LisandroMT/arduino_torreta/images/Gemini_Generated_Image_thl9xkthl9xkthl9.png

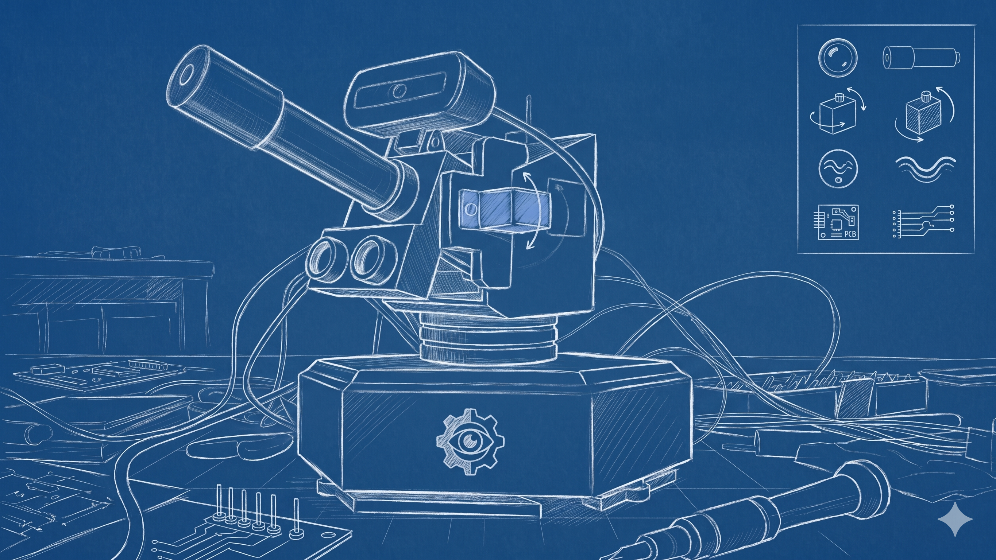
images/Gemini_Generated_Image_thl9xkthl9xkthl9.png
