LisandroMT/arduino_torreta/docs/img/cam1.jpeg

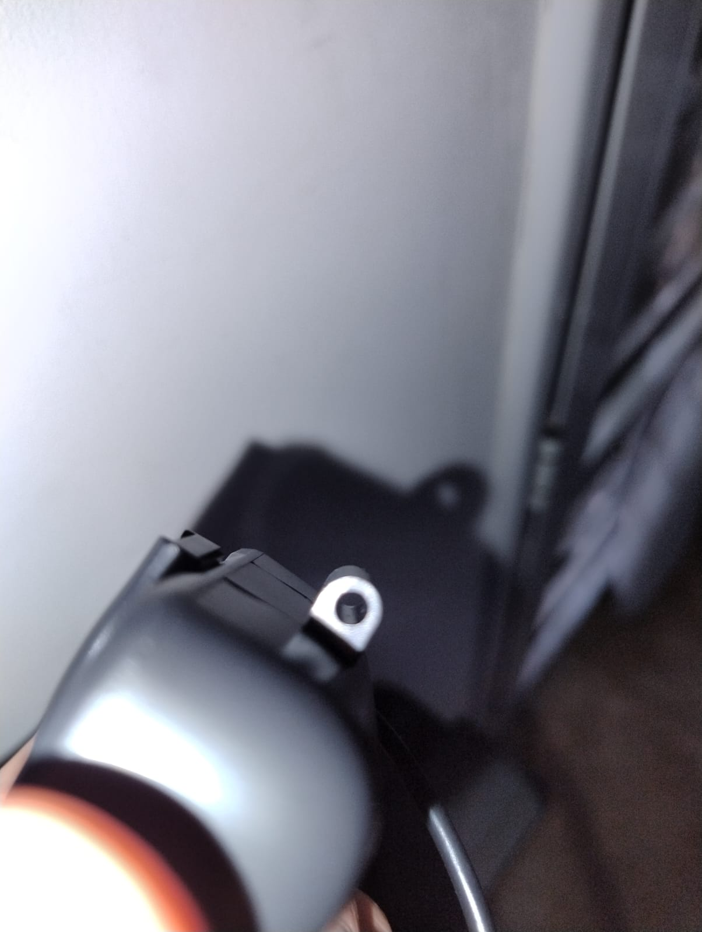
docs/img/cam1.jpeg
