LisandroMT/arduino_torreta/docs/img/cam2.jpeg

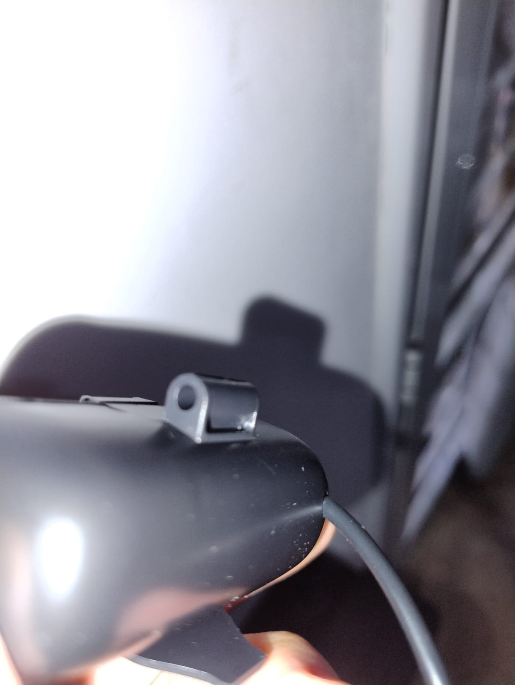
docs/img/cam2.jpeg
