LisandroMT/arduino_torreta/docs/img/cam3.jpeg

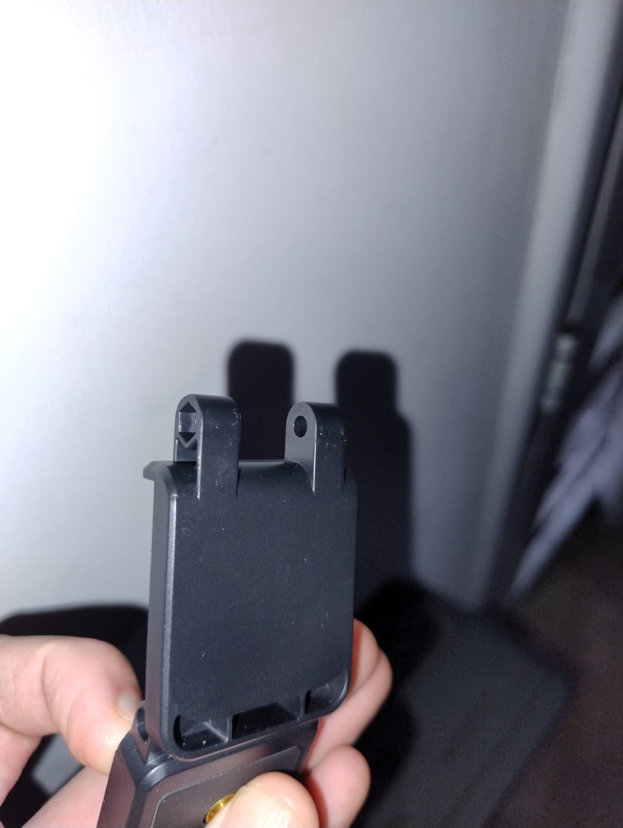
docs/img/cam3.jpeg
