LisandroMT/arduino_torreta/docs/img/cam5.jpeg

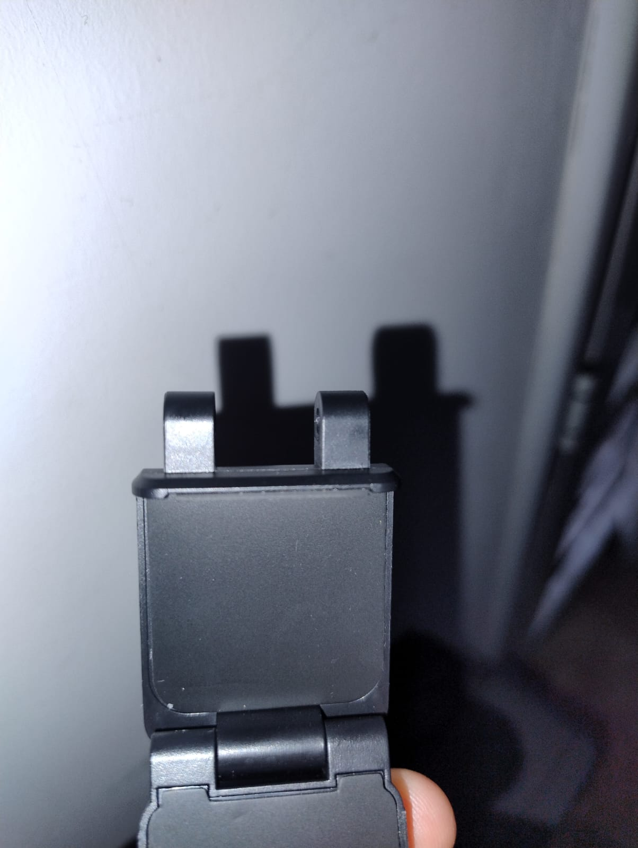
docs/img/cam5.jpeg
