LisandroMT/arduino_torreta/docs/img/cam6.jpeg

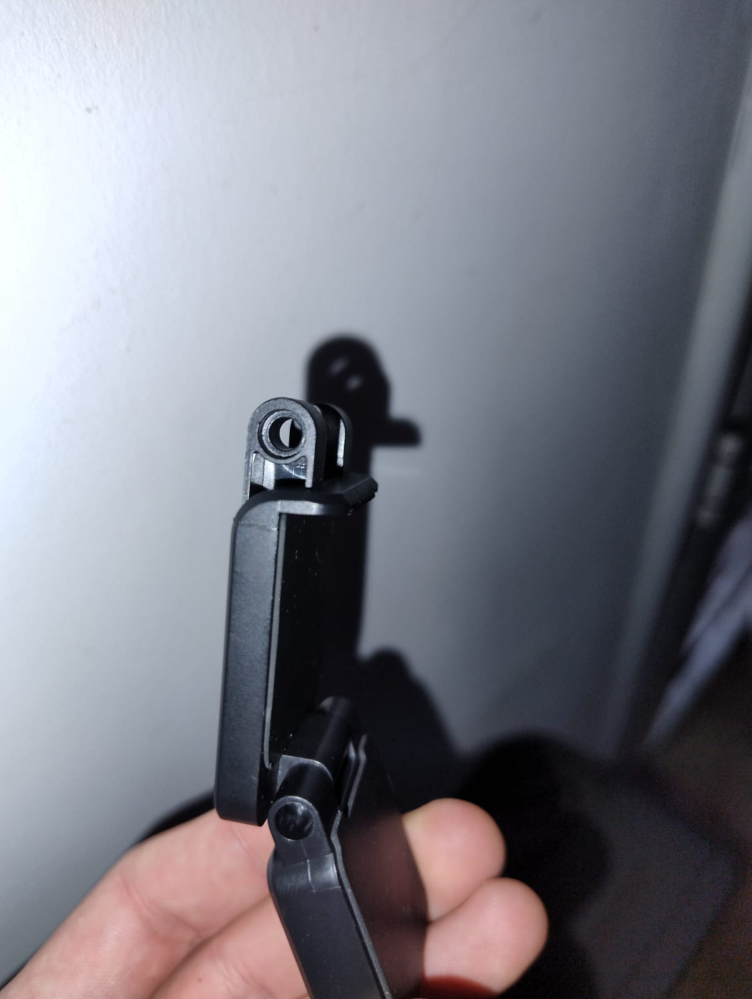
docs/img/cam6.jpeg
