LisandroMT/arduino_torreta/docs/img/esquema_conexiones.png

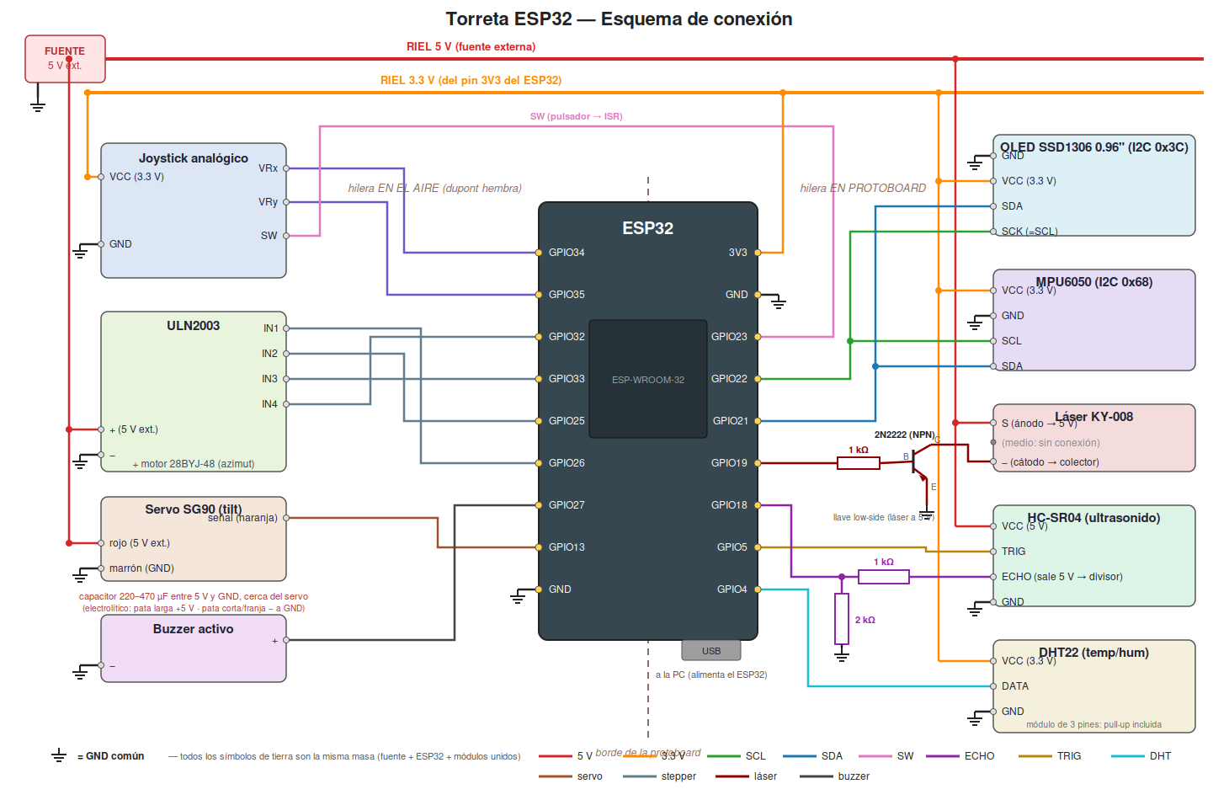
docs/img/esquema_conexiones.png
