LisandroMT/arduino_torreta/images/Gemini_Generated_Image_1i4kce1i4kce1i4k.png

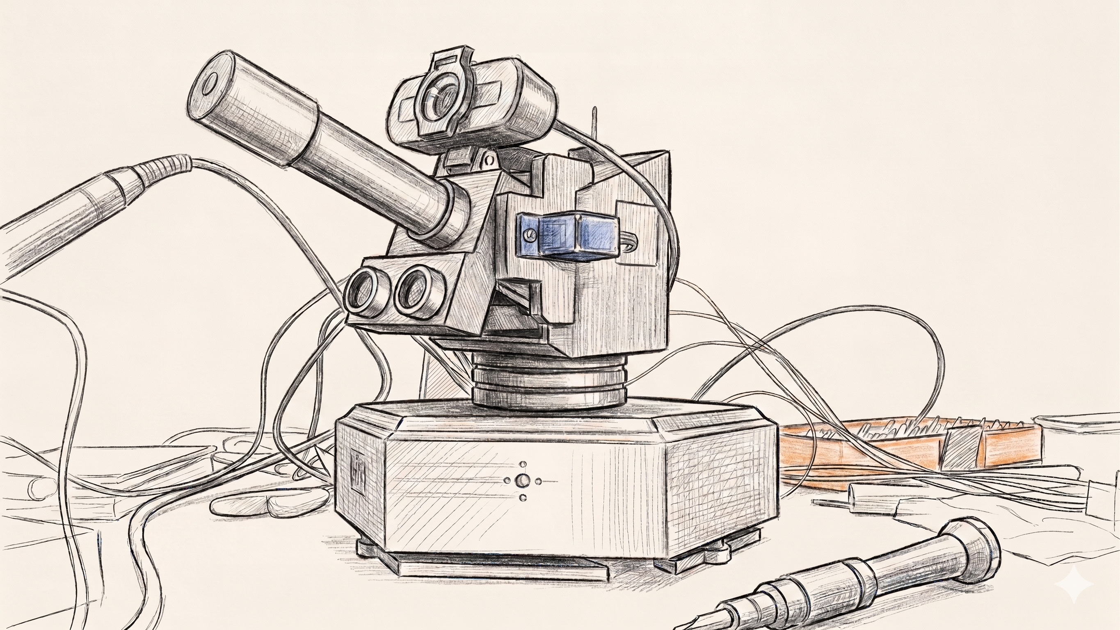
images/Gemini_Generated_Image_1i4kce1i4kce1i4k.png
