LisandroMT/arduino_torreta/images/Gemini_Generated_Image_pfi8p9pfi8p9pfi8.png

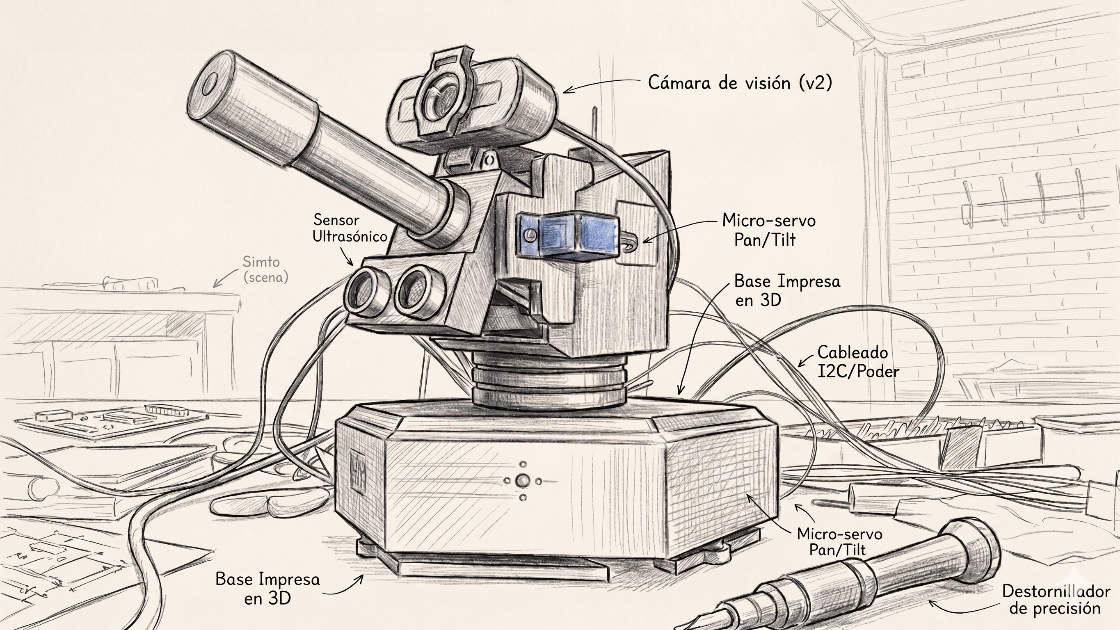
images/Gemini_Generated_Image_pfi8p9pfi8p9pfi8.png
