LisandroMT/arduino_torreta/images/WhatsApp Image 2026-06-18 at 01.02.19.jpeg

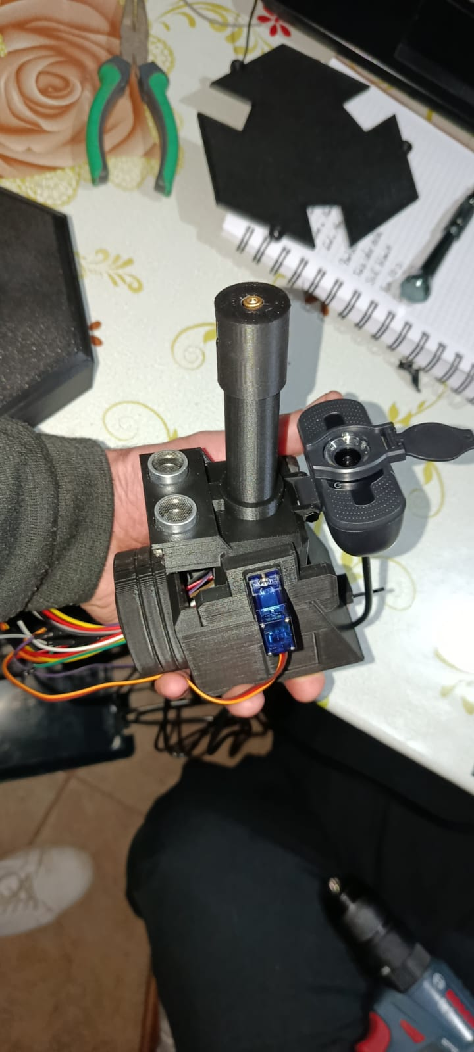
images/WhatsApp Image 2026-06-18 at 01.02.19.jpeg
