LisandroMT/arduino_torreta/images/WhatsApp Image 2026-06-18 at 11.49.33.jpeg

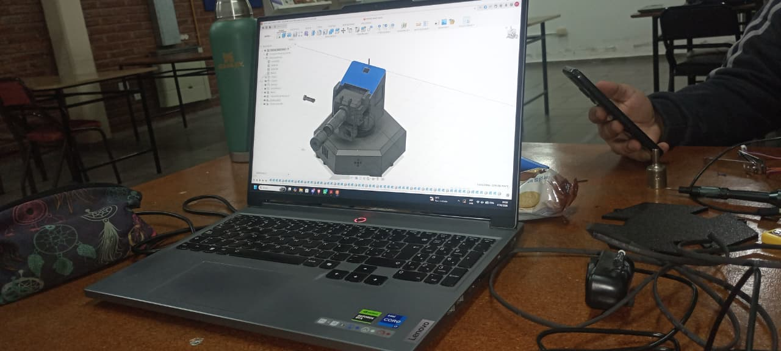
images/WhatsApp Image 2026-06-18 at 11.49.33.jpeg
