LisandroMT/arduino_torreta/diseño_maqueta/componentes/ESP32 DevkitV1.step

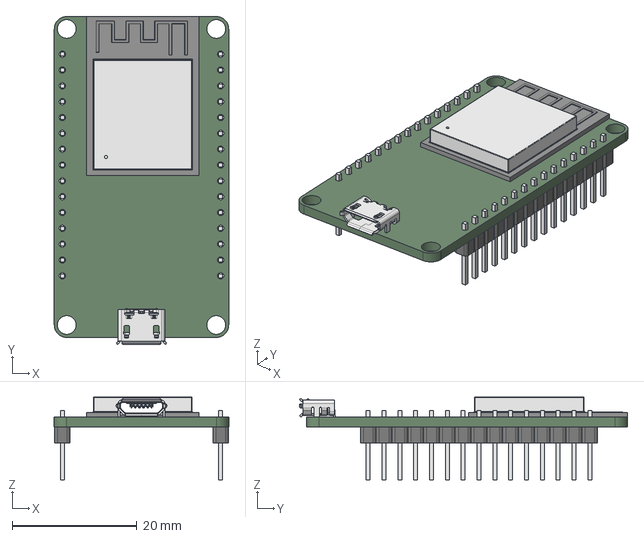
[picture p40: CAD file, 2026-06-15]
diseño_maqueta/componentes/ESP32 DevkitV1.step
28.0 x 52.6 x 13.3 mm
