LisandroMT/arduino_torreta/diseño_maqueta/outputs/cupones/cupon_02_encastre_eje.stl

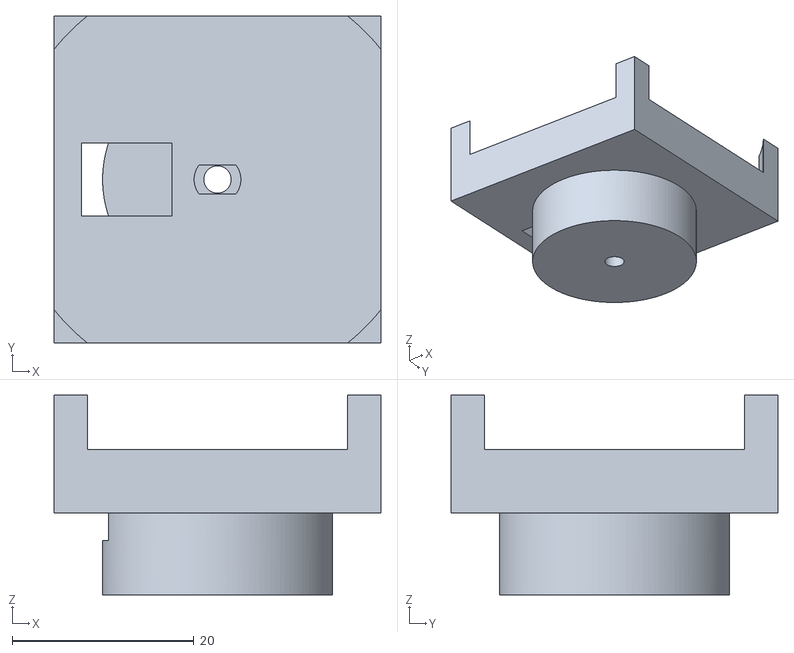
[picture p41: CAD file, 2026-06-15]
diseño_maqueta/outputs/cupones/cupon_02_encastre_eje.stl
36.0 x 36.0 x 22.0
