LisandroMT/arduino_torreta/diseño_maqueta/outputs/parts_fase2/base.stl

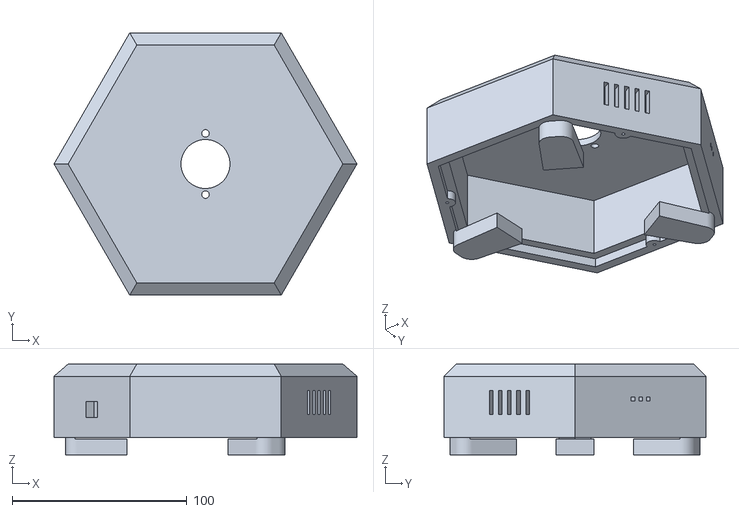
[picture p42: CAD file, 2026-06-15]
diseño_maqueta/outputs/parts_fase2/base.stl
173.2 x 150.0 x 52.0
