LisandroMT/arduino_torreta/diseño_maqueta/outputs/torreta_fase2.step

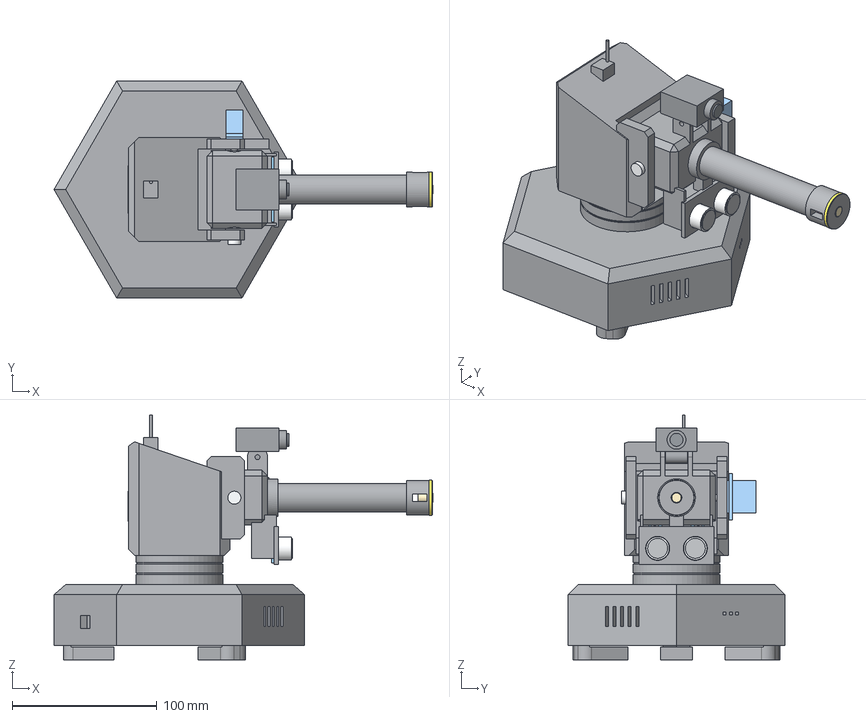
[picture p43: CAD file, 2026-06-15]
diseño_maqueta/outputs/torreta_fase2.step
261.9 x 150.0 x 169.0 mm
