LisandroMT/arduino_torreta/diseño_maqueta/componentes/OLED TEMU 0.96 in.stp

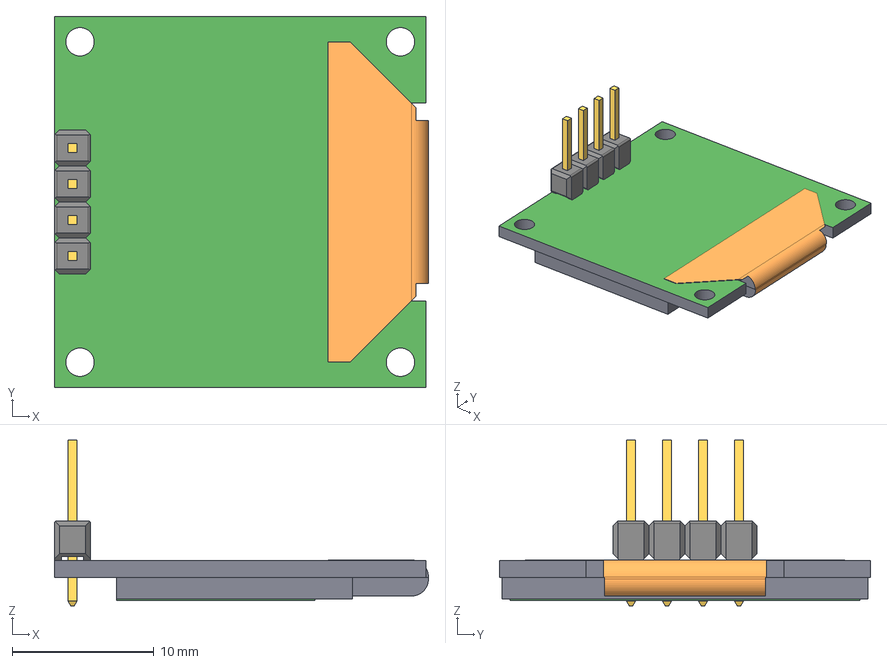
[picture p44: CAD file, 2026-06-15]
diseño_maqueta/componentes/OLED TEMU 0.96 in.stp
26.4 x 26.2 x 11.7 mm
brep_2 x 4
