LisandroMT/arduino_torreta/diseño_maqueta/outputs/cupones/cupon_03a_boss_tapa_base.stl

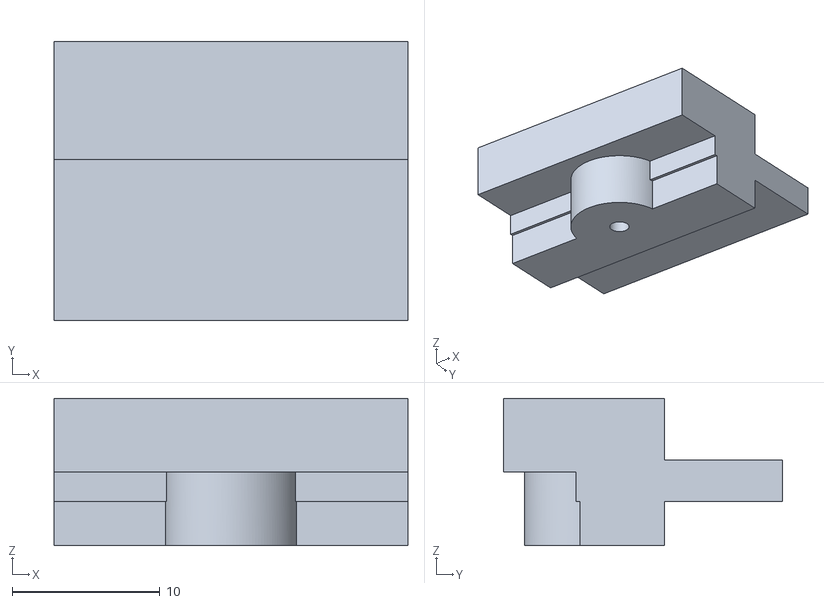
[picture p45: CAD file, 2026-06-15]
diseño_maqueta/outputs/cupones/cupon_03a_boss_tapa_base.stl
24.0 x 18.9 x 10.0
