LisandroMT/arduino_torreta/diseño_maqueta/outputs/parts_fase2/cuerpo.stl

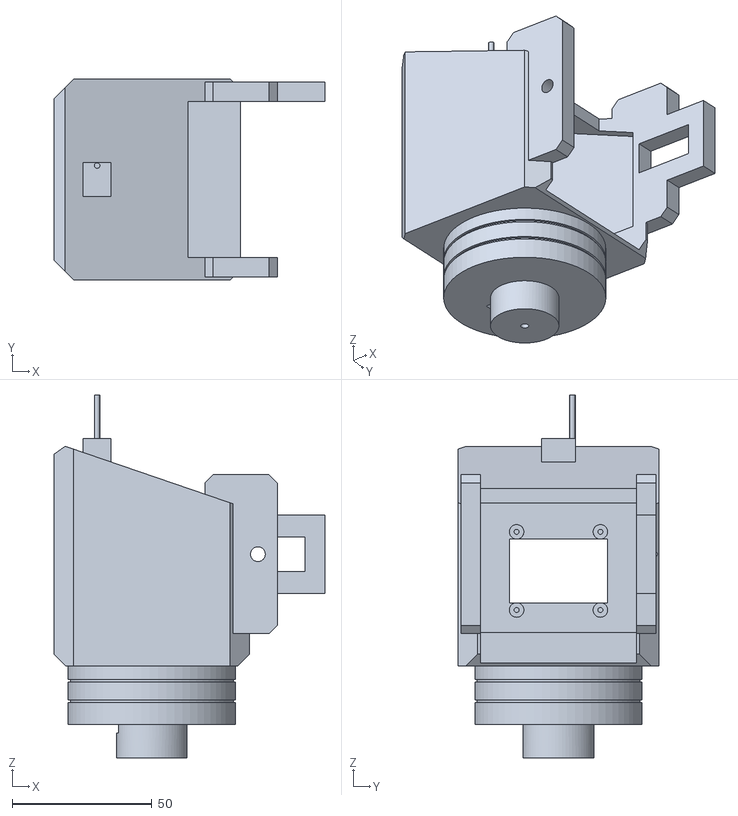
[picture p46: CAD file, 2026-06-15]
diseño_maqueta/outputs/parts_fase2/cuerpo.stl
97.0 x 72.0 x 130.0
