LisandroMT/arduino_torreta/diseño_maqueta/outputs/cupones/cupon_03b_oreja_tapa.stl

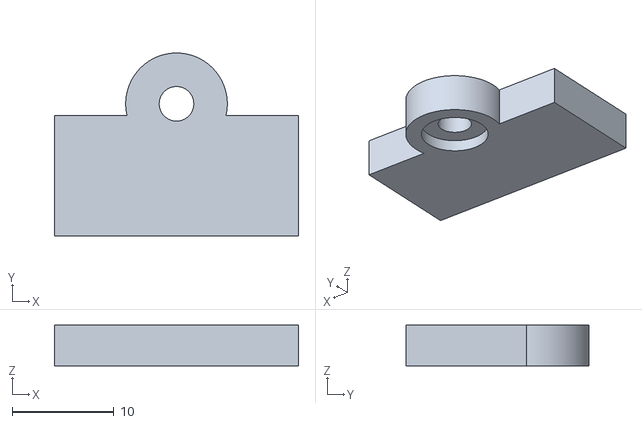
[picture p47: CAD file, 2026-06-15]
diseño_maqueta/outputs/cupones/cupon_03b_oreja_tapa.stl
24.0 x 18.0 x 4.00
