LisandroMT/arduino_torreta/diseño_maqueta/outputs/parts_fase2/canon_cuna.stl

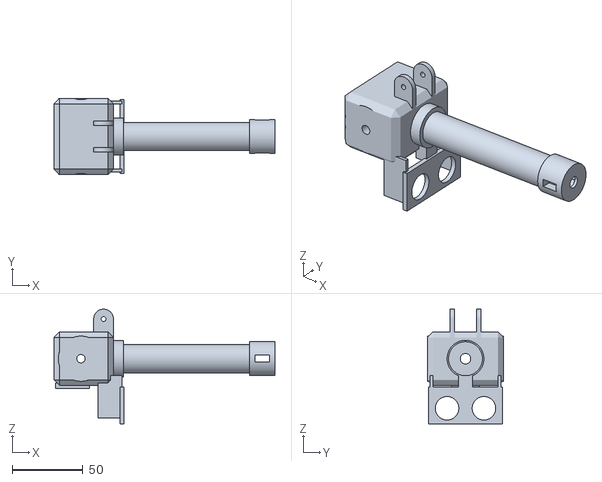
[picture p48: CAD file, 2026-06-15]
diseño_maqueta/outputs/parts_fase2/canon_cuna.stl
156.0 x 54.0 x 81.0
