LisandroMT/arduino_torreta/diseño_maqueta/outputs/cupones/cupon_01_soporte_motor.stl

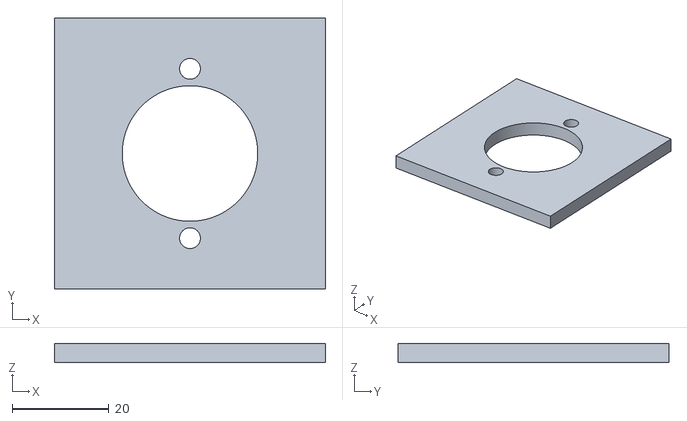
[picture p49: CAD file, 2026-06-15]
diseño_maqueta/outputs/cupones/cupon_01_soporte_motor.stl
56.0 x 56.0 x 4.00
