LisandroMT/arduino_torreta/diseño_maqueta/outputs/parts_fase2/tapa.stl

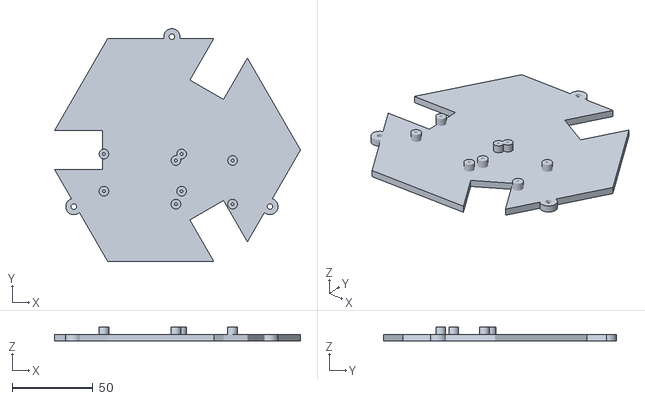
[picture p50: CAD file, 2026-06-14]
diseño_maqueta/outputs/parts_fase2/tapa.stl
152.1 x 143.8 x 8.50
