LisandroMT/arduino_torreta/diseño_maqueta/outputs/cupones/cupon_04_postes_oled.stl

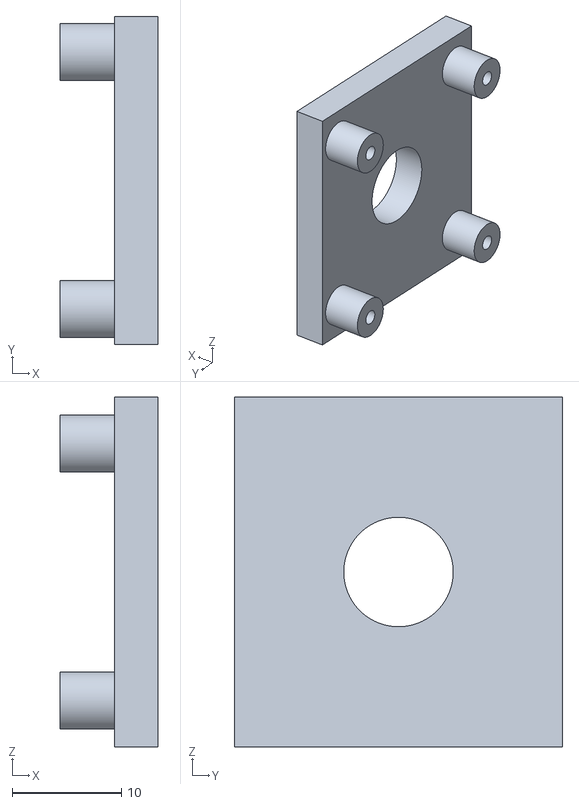
[picture p51: CAD file, 2026-06-15]
diseño_maqueta/outputs/cupones/cupon_04_postes_oled.stl
9.00 x 30.0 x 32.0
