LisandroMT/arduino_torreta/diseño_maqueta/outputs/cupones/_montaje.png

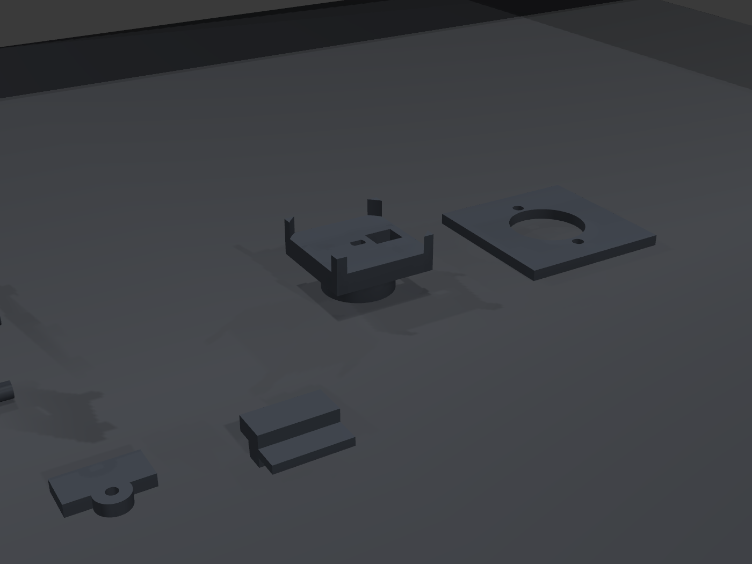
diseño_maqueta/outputs/cupones/_montaje.png
