LisandroMT/arduino_torreta/(commit log)

2026-06-07 Initial commit: torreta láser/escáner 3D - diseño CAD e informes TFI
    [base.step, base.stl, body.step, body.stl, gun.step, gun.stl, mdf_corte.dxf]
2026-06-07 Nueva descripción del proyecto: torreta de seguimiento y apuntado
    - Reescribe el alcance a torreta de seguimiento (sin escaneo 3D)
    - ESP32 + OpenCV, modos autónomo/manual conmutables
    - ISR por pulsador del joystick, fusión cámara+ultrasonido
    - Archiva los informes TFI anteriores en docs/archivo/
2026-06-07 Reorganiza diseño: renombra diseño/ a diseño_maqueta/ y limpia archivos sueltos
    [base.step, base.stl, body.step, body.stl, gun.step, gun.stl, mdf_corte.dxf]
2026-06-11 Cámara sobre la torreta, enlace USB-serie, azimut ±180° y casos de uso
    - La webcam va montada sobre la torreta, coaxial con el cañón
    - Comunicación PC↔ESP32 por cable USB-serie en lugar de WiFi
    - Azimut acotado a un sector de ±180° para que el cableado no se enrede
    - La PC muestra en pantalla la distancia medida por el ultrasonido
    - Nueva sección 9: casos de uso (escenarios de operación), CU-01 a CU-07
2026-06-12 Guía de armado del circuito, esquema de conexión y simulación Wokwi
    - docs/CONEXIONES.md: paso a paso del cableado con mapa de pines,
    montaje del ESP32 al borde de la protoboard (hilera colgante con
    dupont hembra), checklist de inspección y encendido por etapas
    - docs/img/: esquema de conexión (SVG + PNG) con código de colores,
    divisor del ECHO y distribución de alimentación
    - wokwi/: simulación completa (diagram.json, firmware de prueba con
    FSM/ISR/compensación térmica, chip personalizado ULN2003 y README
    con recetas para probar los casos de uso CU-01 a CU-07)
2026-06-12 Nodo de percepción en PC: seguimiento por color y por mano (OpenCV + MediaPipe)
    - pc/seguimiento.py: captura de la webcam (Gadnic WEBL56, 640x480 MJPG baja
    latencia), detección por color HSV con calibración interactiva, detección
    de manos con esqueleto de 21 puntos (MediaPipe, tecla 'r' alterna objetivo),
    lazo proporcional con zona muerta y envío de correcciones por USB-serie
    (protocolo compartido con el firmware/Wokwi), telemetría con la distancia
    del ultrasonido en pantalla, manejo robusto de ventanas y consola Windows
    - pc/README.md: instalación, calibración, ajuste de ganancias y protocolo
    - pc/requirements.txt (mediapipe fijado a 0.10.14: las nuevas quitan mp.solutions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
2026-06-12 CAD: diseño V2 open-frame, maqueta V3 hueca y Torreta Fase 2 imprimible
    - torreta_v2.py: concepto open-frame con componentes a medidas de datasheet
    - maqueta_v3.py: primera maqueta hueca de 5 piezas con alojamientos
    - torreta_fase2.py: la definitiva — geometría esculpida de Fase 1 ahuecada
    por cirugía booleana, cañón único con el KY-008 en la punta, todos los
    componentes del BOM alojados (ESP32, ULN2003, 28BYJ-48 con cubo en D,
    SG90, HC-SR04 en mentonera, GY-521, DHT22 ventilado, LCD en pod-consola
    sobre cara plana, buzzer, joystick, bandeja webcam), pasacables interno,
    rango de tilt verificado (-5°..+30°) y DOS gates previos al export:
    conexidad (sin piezas flotantes)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
    [base.stl, canon_cuna.stl, cuerpo.stl, mantelete.stl, racimo.stl, tambor_cuerpo.stl, tapa.stl, torreta_fase2.step]
2026-06-12 Visores 3D interactivos en HTML (autocontenidos, GLB embebido)
    - torreta_fase2_3d.html: el visor principal — ARTICULADO (sliders de azimut
    ±180° y elevación -5°..+30° sobre el pivote real del muñón) + vista
    explotada por pieza con slider, carga 4 GLB embebidos en base64
    - maqueta_3d.html, prototipo_3d.html, prototipo_v2_3d.html,
    maqueta_v3_3d.html: visores de las iteraciones anteriores del diseño
    - torreta_v2_interactiva.html, torreta_gatling_interactiva.html: prototipos
    procedurales Three.js con modo demo, selección de piezas y explotado
2026-06-14 Esquema de conexión: láser de 3 terminales, capacitor del servo, símbolos de tierra y OLED
    - Láser KY-008 dibujado con sus 3 terminales reales (el del medio NC)
    - Capacitor del servo: detalle de polaridad y conexión (electrolítico ≥10V)
    - GND con símbolos de tierra (⏚) por componente en vez de cables ruteados,
    mucho más legible; positivos y señales siguen ruteados
    - Display migrado de LCD 1602 (5V, 0x27) a OLED SSD1306 (3.3V, 0x3C),
    con el reloj rotulado SCK (=SCL) como en el módulo real
    - Nota: 2×1kΩ en serie equivalen a la resistencia de 2k del divisor del ECHO
2026-06-14 Migración de pantalla LCD 1602 a OLED SSD1306 0.96" (descripción + Wokwi)
    - DESCRIPCION_PROYECTO.md: display OLED en resumen, arquitectura, tabla de
    componentes, casos de uso y BOM (gráfico 128x64, I2C 0x3C, 3.3V)
    - wokwi/diagram.json: part board-ssd1306, VCC a 3V3 (no 5V)
    - wokwi/sketch.ino: Adafruit_SSD1306 + GFX en vez de LiquidCrystal_I2C;
    la distancia se dibuja en grande, misma información que antes
    - wokwi/libraries.txt y README.md actualizados
2026-06-14 Maqueta Fase 2: OLED atrás del cuerpo, servo corregido, cámara con horquilla, base limpia
    - OLED montado en la cara trasera del cuerpo (4 postes M2 + paso de cables al
    hueco interno); se eliminó el voluminoso pod-consola de la base (−47 cm³)
    - Servo SG90 reorientado: eje de salida hacia adentro engranando la cuna
    (antes apuntaba al aire, montado al revés)
    - Cámara: quitado el soporte/bandeja que chocaba al elevar el cañón;
    reemplazado por 2 pestañas tipo horquilla con agujero M3 para el buje
    pivotante de la webcam (verificado: despeja con el cañón a +28°)
    - Quitados los chevrones amarillos de la base
    - Las 4 piezas siguen pasando los gates (conexas, estancas, imprimible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
    [base.stl, canon_cuna.stl, cuerpo.stl, torreta_fase2.step]
2026-06-14 Maqueta: separar estructura/electrónica, toggle "solo maqueta", cámara con horquilla y STEP jerárquico
    - Visor HTML: botón "Solo maqueta (ocultar electrónica)"; el CAD ahora exporta
    GLB por (pieza × tipo) → 8 GLB, el visor oculta los *_componentes
    - Cámara Gadnic CAMWEB11: pestañas tipo horquilla con separación interior
    parametrizada al cilindro de pivote real (CAM_BUJE_L = 15 mm medido)
    - STEP exportado con jerarquía nombrada (Torreta → pieza → estructura/
    electronica → sólidos) para que Fusion lo lea como componentes agrupados
    - Modelo en Z-up (estándar STEP/impresión); renders y STL regenerados
    [canon_cuna.stl, torreta_fase2.step]
2026-06-14 Docs: manual y fotos de la cámara Gadnic CAMWEB11 (referencia del montaje)
    - CAMWEB11.pdf: manual del fabricante (specs ópticas/eléctricas)
    - cam1-6.jpeg: fotos de la cámara desarmada mostrando el clip a quitar y el
    cilindro de pivote (15 mm) que las pestañas de la torreta abrazan
2026-06-14 Maqueta: base con tapa inferior real, refuerzos estructurales y cable-management anti-guillotina
    - Unión tambor↔cuerpo reforzada con bloque macizo (sección 691→3400 mm²):
    transmite el torque del azimut sin pestañas frágiles
    - Quitados los tabiques amarillos internos del cuerpo (decorativos de Fase 1)
    - BASE rediseñada: ahora es un vaso abierto por abajo con TAPA inferior real
    (acceso a la electrónica); patas más chicas y la tapa con muescas que copian
    su forma para montarla sin chocar; 3 tornillos M3 entre las patas
    - Montaje del 28BYJ-48 corregido con cotas reales: cuerpo Ø28 con el eje
    DESCENTRADO 8 mm, eje en r=0 (eje de giro) que encastra en el agujero en D
    del cue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
    [base.stl, cuerpo.stl, tapa.stl, torreta_fase2.step]
2026-06-14 Coherencia: azimut a ±90° (180° de barrido) en firmware y documentación
    El rango de giro se limita a ±90° — el máximo que la ranura arqueada del cable
    garantiza sin efecto guillotina (verificado por cálculo). Antes el firmware
    permitía ±180° (360°), incoherente con la mecánica.
    - wokwi/sketch.ino: LIMITE_AZIMUT = PASOS_POR_VUELTA/4 (±1024 pasos)
    - DESCRIPCION_PROYECTO.md: sector ±90° en objetivos, alcance, tabla y CU-07,
    con el motivo (ranura del cable / anti-guillotina)
    - wokwi/README.md: CU-07 a ±90° (±1024 pasos)
2026-06-15 Mejoras de imprimibilidad y montaje de la maqueta + componentes reales
    Estructura (torreta_fase2.py):
    - Funda del joystick agrandada a las medidas reales del KY-023
    - Pestañas de la cámara redondeadas (lomo semicircular)
    - Cañón engrosado: conducto Ø17->Ø13 (pared 1.5->3.5 mm) y se quitan
    las ranuras térmicas (eliminan el único punto fino del tubo)
    - OLED embutido: ventana 35x23 mm + 4 bosses internos (patrón 30x28),
    se ven solo la pantalla; PCB y cables quedan ocultos adentro
    - Ventana trasera en la cuna: alivia peso y da acceso al MPU6050;
    agujeros del MPU a 15 mm centro a centro
    Nuevos:
    - MONTAJE_COMPONENTES.md: mapa de coordenadas para ensamblar en Fusion
    - cupones.py + o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
    [ESP32 DevkitV1.step, OLED TEMU 0.96 in.stp, base.stl, canon_cuna.stl, cuerpo.stl, cupon_01_soporte_motor.stl, cupon_02_encastre_eje.stl, cupon_03a_boss_tapa_base.stl]
2026-06-15 Limpieza del repo: elimina versiones viejas y artefactos regenerables
    - Versiones superadas: maqueta_v3.py, torreta_v2.py, torreta_mdf.py,
    render_foto_v2.py y sus renders (v2_*, v3_*, torreta_*, mdf_*)
    - ejemplos_diseño/ (material de referencia; queda en el historial)
    - 20 renders f2_*.png (regenerables al correr el script) + se gitignora
    outputs/*.png para no versionarlos a futuro
    - 6 viewers HTML huérfanos de versiones viejas (queda torreta_fase2_3d.html)
    - README: arregla imagen rota, ref a ejemplos_diseño/ y 'cd diseño' -> 'cd diseño_maqueta'
    El historial de git conserva todo lo borrado por si hiciera falta.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
    [mdf_corte.dxf]
2026-06-15 Limpieza (2): elimina exports y configs de versiones viejas
    - outputs/: parts/ (V1), parts_v3/, torreta.glb, torreta_v2/v3.glb/.step
    - turret_mdf.yaml (config de la versión MDF ya eliminada)
    - DISEÑO.md (doc de Fase 1, superado por README.md + DESCRIPCION_PROYECTO.md)
    outputs/ queda solo con los artefactos fase2 + cupones. Historial conserva todo.
    [base.step, base.stl, body.step, body.stl, gun.step, gun.stl, mantelete.stl, racimo.stl]
2026-06-15 Limpieza (3): elimina el informe viejo "Torreta Laser"
    docs/archivo/ queda solo con el informe oficial actual
    "Torreta-Escaner 3D" (.md fuente + .pdf). El historial conserva el viejo.
2026-06-15 Maqueta: quita el joystick KY-023 de la base
    El joystick irá en un soporte/mando externo, así que ya no se imprime ni
    se aloja en la base de la maqueta. Cambios en torreta_fase2.py:
    - elimina la funda lateral del joystick en construir_base()
    - elimina el componente visual (PCB, domo, palanca) del ensamble
    - saca ("Joystick","base") del mapeo BOM componente->pieza
    Doc de montaje actualizada (joystick = mando externo, ubicación a definir) y
    outputs regenerados (solo cambió la base): STEP/GLB de la maqueta, GLB de la
    base y base.stl. Gates de conexidad e imprimibilidad OK en las 4 piezas.
    [base.stl, torreta_fase2.step]
2026-06-18 Puesta en marcha en HW real: firmware de control + vision calibrados
    Firmware: homing a posicion fija (el MPU ya no comanda el servo, va fijo a la base) elimina el runaway de elevacion; suavizado del servo y stepper mas controlado (velocidad de aproximacion + apuntado fino + freno al centrar, sin overshoot/backlog); RANGO_MIN_CM bajado porque el canon tapa el HC-SR04.
    Vision (pc/seguimiento.py): lazo de apuntado ajustado (inversion de azimut, ganancias/topes y zona muerta para evitar sobrecorreccion y oscilacion); mira calibrable del paralaje camara-laser con W/A/S/D, persistida en mira.json.
    Otros: .tools/ (binario arduino-cli) al .gitignore; docs/CONEXIONES y DESCRIPCION actualizados; ma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
    [firmware.ino, i2cscan.ino, oledtest.ino, seguimiento.py, wokwi.ino]
